hamedzurat/silicon-operator/(commit log)

2026-10-08 refactor: unify ROM program loading with readmemh and update synthesis workflow for schematic viewing
2026-10-08 docs: add physical design metrics, build results, and schematic assets to README
